Beirdo/keurig-filler/hardware/keurig-filler/schematic.pdf

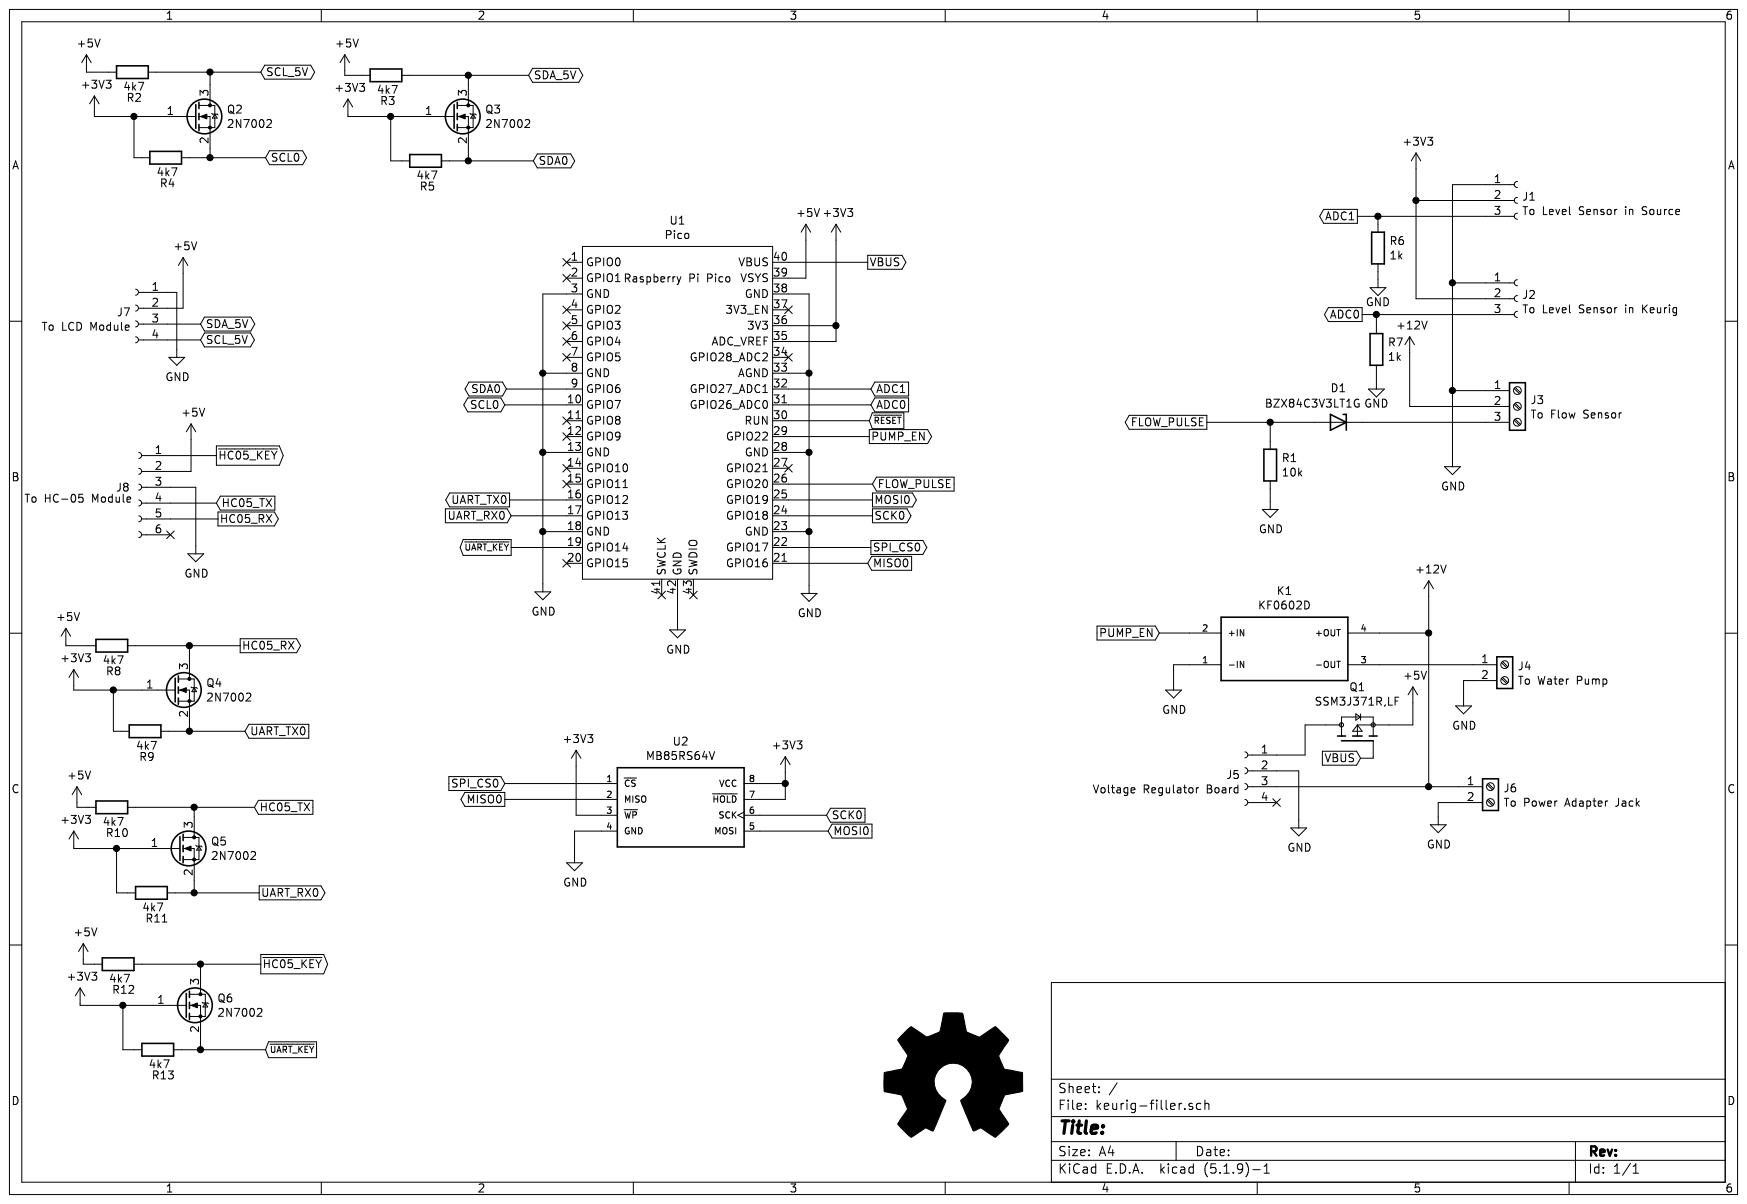
[picture p1: page 1]
