Beirdo/keurig-filler/hardware/keurig-filler/keurig-filler.kicad_pcb

## KiCad design hardware/keurig-filler/keurig-filler.kicad_pcb (2022-01-23)

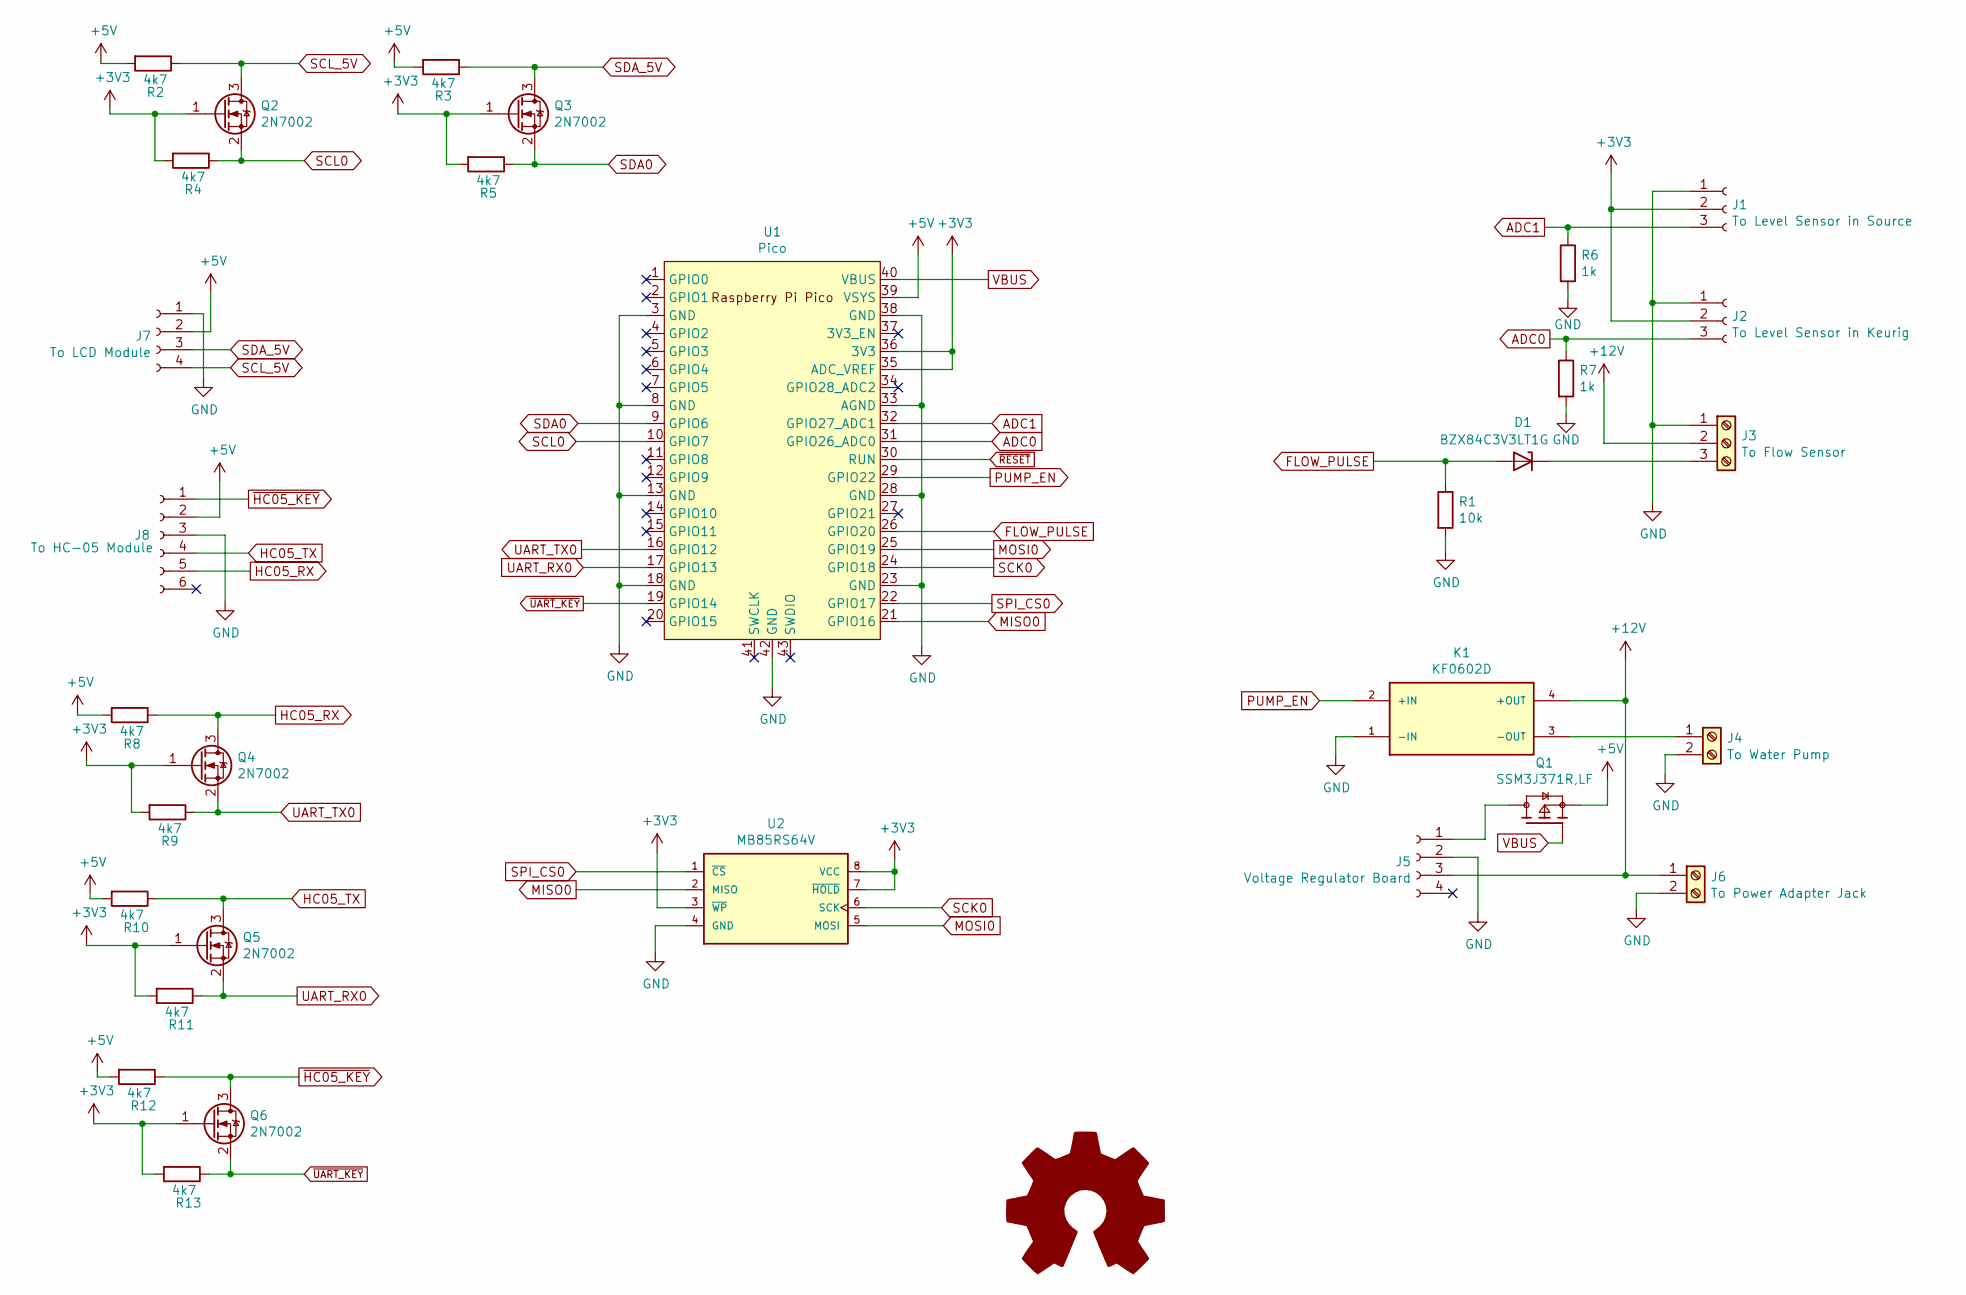
[picture p2: schematic keurig-filler.sch]

Parts:
D1: BZX84C3V3LT1G; D_SOT-23_ANK
J1: To Level Sensor in Source; PinHeader_1x03_P2.54mm_Vertical
J2: To Level Sensor in Keurig; PinHeader_1x03_P2.54mm_Vertical
J3: To Flow Sensor; TerminalBlock_Altech_AK300-3_P5.00mm
J4: To Water Pump; TerminalBlock_Altech_AK300-2_P5.00mm
J5: Voltage Regulator Board; PinHeader_1x04_P2.54mm_Vertical
J6: To Power Adapter Jack; TerminalBlock_Altech_AK300-2_P5.00mm
J7: To LCD Module; PinHeader_1x04_P2.54mm_Vertical
J8: To HC-05 Module; PinHeader_1x06_P2.54mm_Vertical
K1: KF0602D; RELAY_KF0602D; PARTREV N/A
Q1: ‎SSM3J371R,LF‎; SOT91P240X110-3N_DMG2305UX-7; PARTREV 09/2018
Q2, Q3, Q4, Q5, Q6: 2N7002; SOT-23
R1: 10k; R_0805_2012Metric_Pad1.20x1.40mm_HandSolder
R2, R3, R4, R5, R8, R9, R10, R11, R12, R13: 4k7; R_0805_2012Metric_Pad1.20x1.40mm_HandSolder
R6, R7: 1k; R_0805_2012Metric_Pad1.20x1.40mm_HandSolder
U1: Pico; RPi_Pico_SMD_TH
U2: MB85RS64V; SOIC127P600X155-8_R159_68_374R15

Connections:
+3V3: J1.2, J2.2, Q2.1 (G), Q3.1 (G), Q4.1 (G), Q5.1 (G), Q6.1 (G), R4.2, R5.2, R9.2, R11.2, R13.2, U1.35 (ADC_VREF), U1.36 (3V3), U2.3 (~WP), U2.7 (~HOLD), U2.8 (VCC)
+5V: J7.2, J8.2, Q1.2, R2.2, R3.2, R8.2, R10.2, R12.2, U1.39 (VSYS)
+12V: J3.2, J5.3, J6.1, K1.4 (+OUT)
ADC0: J2.3, R7.1, U1.31 (GPIO26_ADC0)
ADC1: J1.3, R6.1, U1.32 (GPIO27_ADC1)
FLOW_PULSE: D1.2 (A), R1.1, U1.26 (GPIO20)
GND: J1.1, J2.1, J3.1, J4.2, J5.2, J6.2, J7.1, J8.3, K1.1 (-IN), R1.2, R6.2, R7.2, U1.3 (GND), U1.8 (GND), U1.13 (GND), U1.18 (GND), U1.23 (GND), U1.28 (GND), U1.33 (AGND), U1.38 (GND), U1.42 (GND), U2.4 (GND)
HC05_RX: J8.5, Q4.3 (D), R8.1
HC05_TX: J8.4, Q5.3 (D), R10.1
MISO0: U1.21 (GPIO16), U2.2 (MISO)
MOSI0: U1.25 (GPIO19), U2.5 (MOSI)
unnamed: D1.1 (K), J3.3
unnamed: J4.1, K1.3 (-OUT)
unnamed: J5.1, Q1.3
PUMP_EN: K1.2 (+IN), U1.29 (GPIO22)
SCK0: U1.24 (GPIO18), U2.6 (SCK)
SCL0: Q2.2 (S), R4.1, U1.10 (GPIO7)
SCL_5V: J7.4, Q2.3 (D), R2.1
SDA0: Q3.2 (S), R5.1, U1.9 (GPIO6)
SDA_5V: J7.3, Q3.3 (D), R3.1
SPI_CS0: U1.22 (GPIO17), U2.1 (~CS)
UART_RX0: Q5.2 (S), R11.1, U1.17 (GPIO13)
UART_TX0: Q4.2 (S), R9.1, U1.16 (GPIO12)
VBUS: Q1.1, U1.40 (VBUS)
~HC05_KEY: J8.1, Q6.3 (D), R12.1
~RESET: U1.30 (RUN)
~UART_KEY: Q6.2 (S), R13.1, U1.19 (GPIO14)

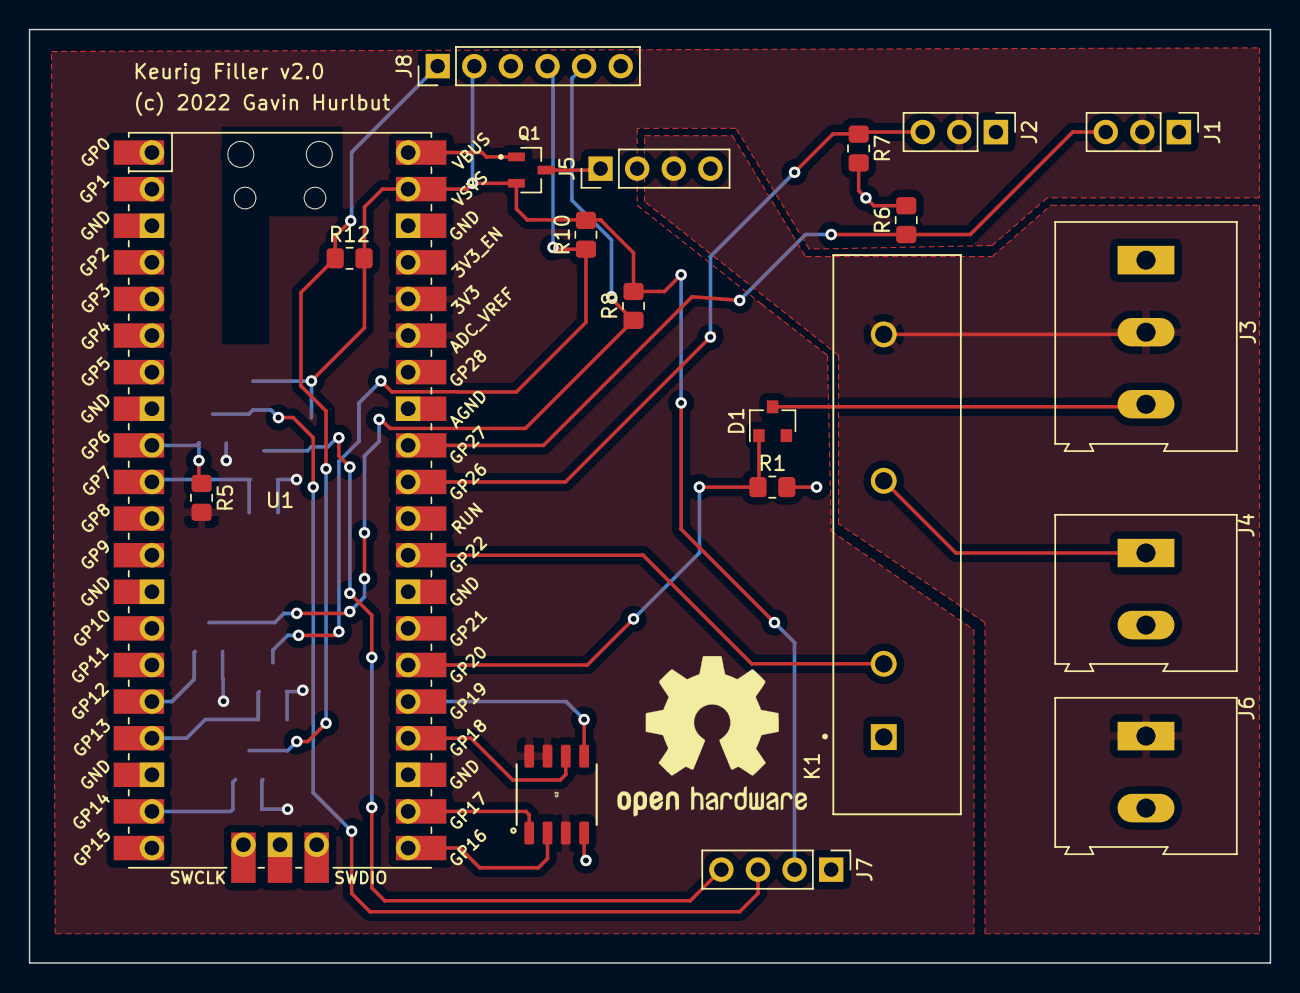
[picture p3: board keurig-filler.kicad_pcb from above]

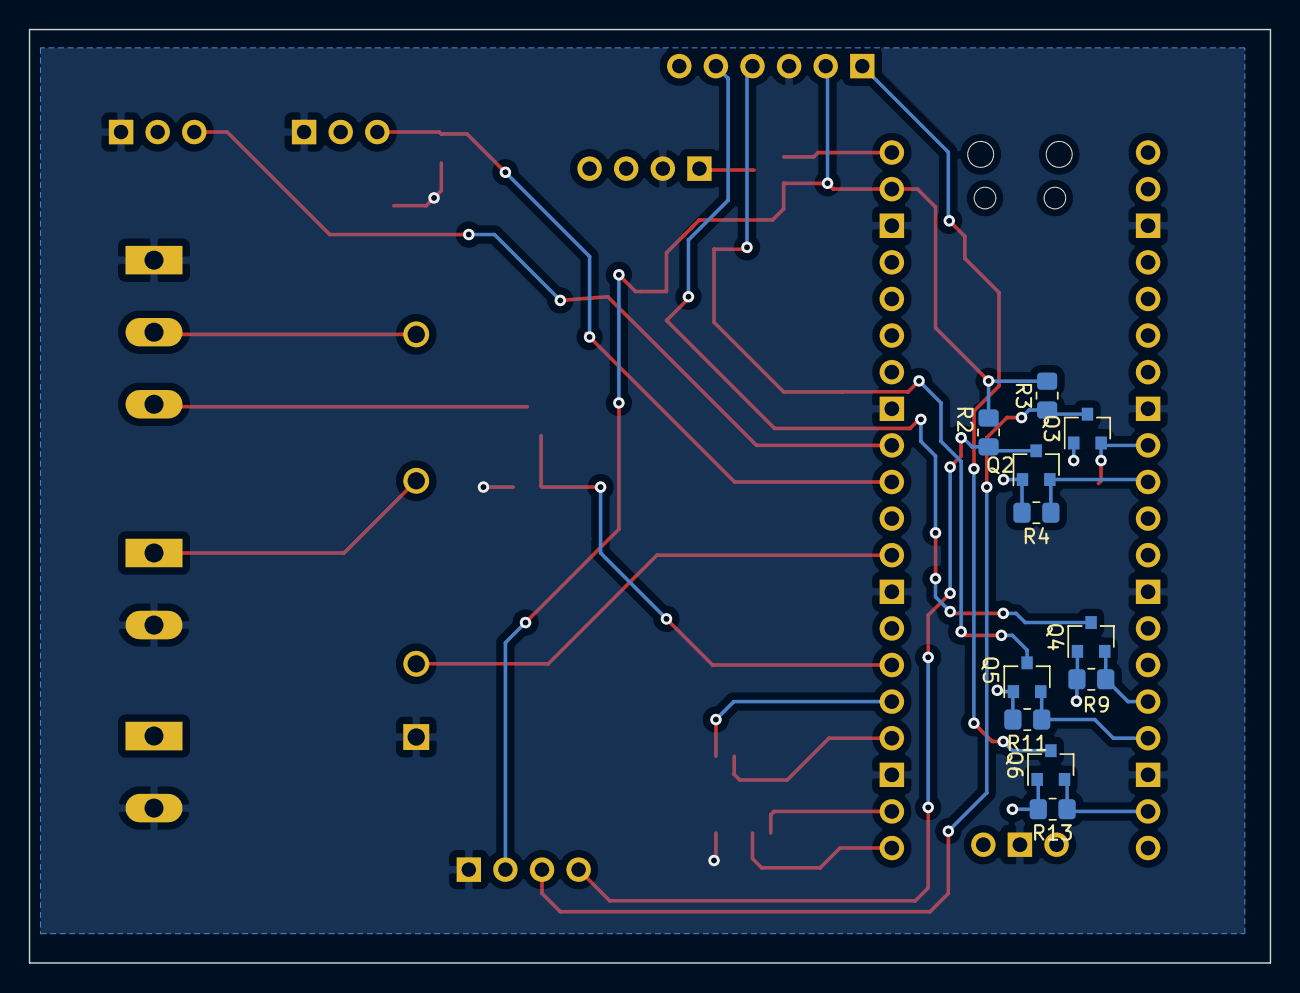
[picture p4: board keurig-filler.kicad_pcb from below]

Board: 2 copper layers, 86.1 x 64.8 mm, 31 parts (11 on the bottom side), 26 nets.
