Beirdo/keurig-filler/(commit log)

2022-01-15 Initial KiCad setup
    [keurig-filler.kicad_pcb, keurig-filler.sch]
2022-01-16 Added Kicad schematic and layout for v1
    [keurig-filler-B_Cu.gbr, keurig-filler-B_Mask.gbr, keurig-filler-B_Paste.gbr, keurig-filler-B_SilkS.gbr, keurig-filler-Edge_Cuts.gbr, keurig-filler-F_Cu.gbr, keurig-filler-F_Mask.gbr, keurig-filler-F_Paste.gbr]
2022-01-16 Add schematic in PDF
2022-01-17 Add initial attempt at MicroPython Firmware
    Note: I don't have the board yet, can't test it.
2022-01-17 Use 12bit ADC readings, not the funky upscaling
2022-01-22 Complete overhaul of water sensor code
    - now doing 8 measurements, and averaging the results before conversion
    - conversion now calculates the resistance (much like with a thermistor), and then uses exponential regression to get the percentage of fullscale reading.
2022-01-22 Created v2 board design
    Adding HC-05 bluetooth module, LCD screen (over I2C) and a FRAM (over SPI). Full firmware support for the FRAM and LCD not yet added.
    Gerbers not yet regenerated.
    [keurig-filler.kicad_pcb, keurig-filler.sch]
2022-01-23 Fleshed out LCD and FRAM use for v2 boards
    Decided to use littlefs on the FRAM, and store the parameters in CBOR format.
2022-01-23 Update gerbers for v2
    [keurig-filler-B_Cu.gbr, keurig-filler-B_Mask.gbr, keurig-filler-B_Paste.gbr, keurig-filler-B_SilkS.gbr, keurig-filler-Edge_Cuts.gbr, keurig-filler-F_Cu.gbr, keurig-filler-F_Mask.gbr, keurig-filler-F_Paste.gbr]
2022-01-23 Moved the hardware directory up one.
    [keurig-filler-B_Cu.gbr, keurig-filler-B_Mask.gbr, keurig-filler-B_Paste.gbr, keurig-filler-B_SilkS.gbr, keurig-filler-Edge_Cuts.gbr, keurig-filler-F_Cu.gbr, keurig-filler-F_Mask.gbr, keurig-filler-F_Paste.gbr]
2022-01-23 Add the gerbers.zip file to the ignores
