Beirdo/keurig-filler/(notices)

Notices in the files:
hardware/keurig-filler/keurig-filler.kicad_pcb:
(c) 2022 Gavin Hurlbut
